Momozavur/STM32H743VIT6-FC/STM32H743VIT6 FC.kicad_pcb

## KiCad design STM32H743VIT6 FC.kicad_pcb (2025-11-29)

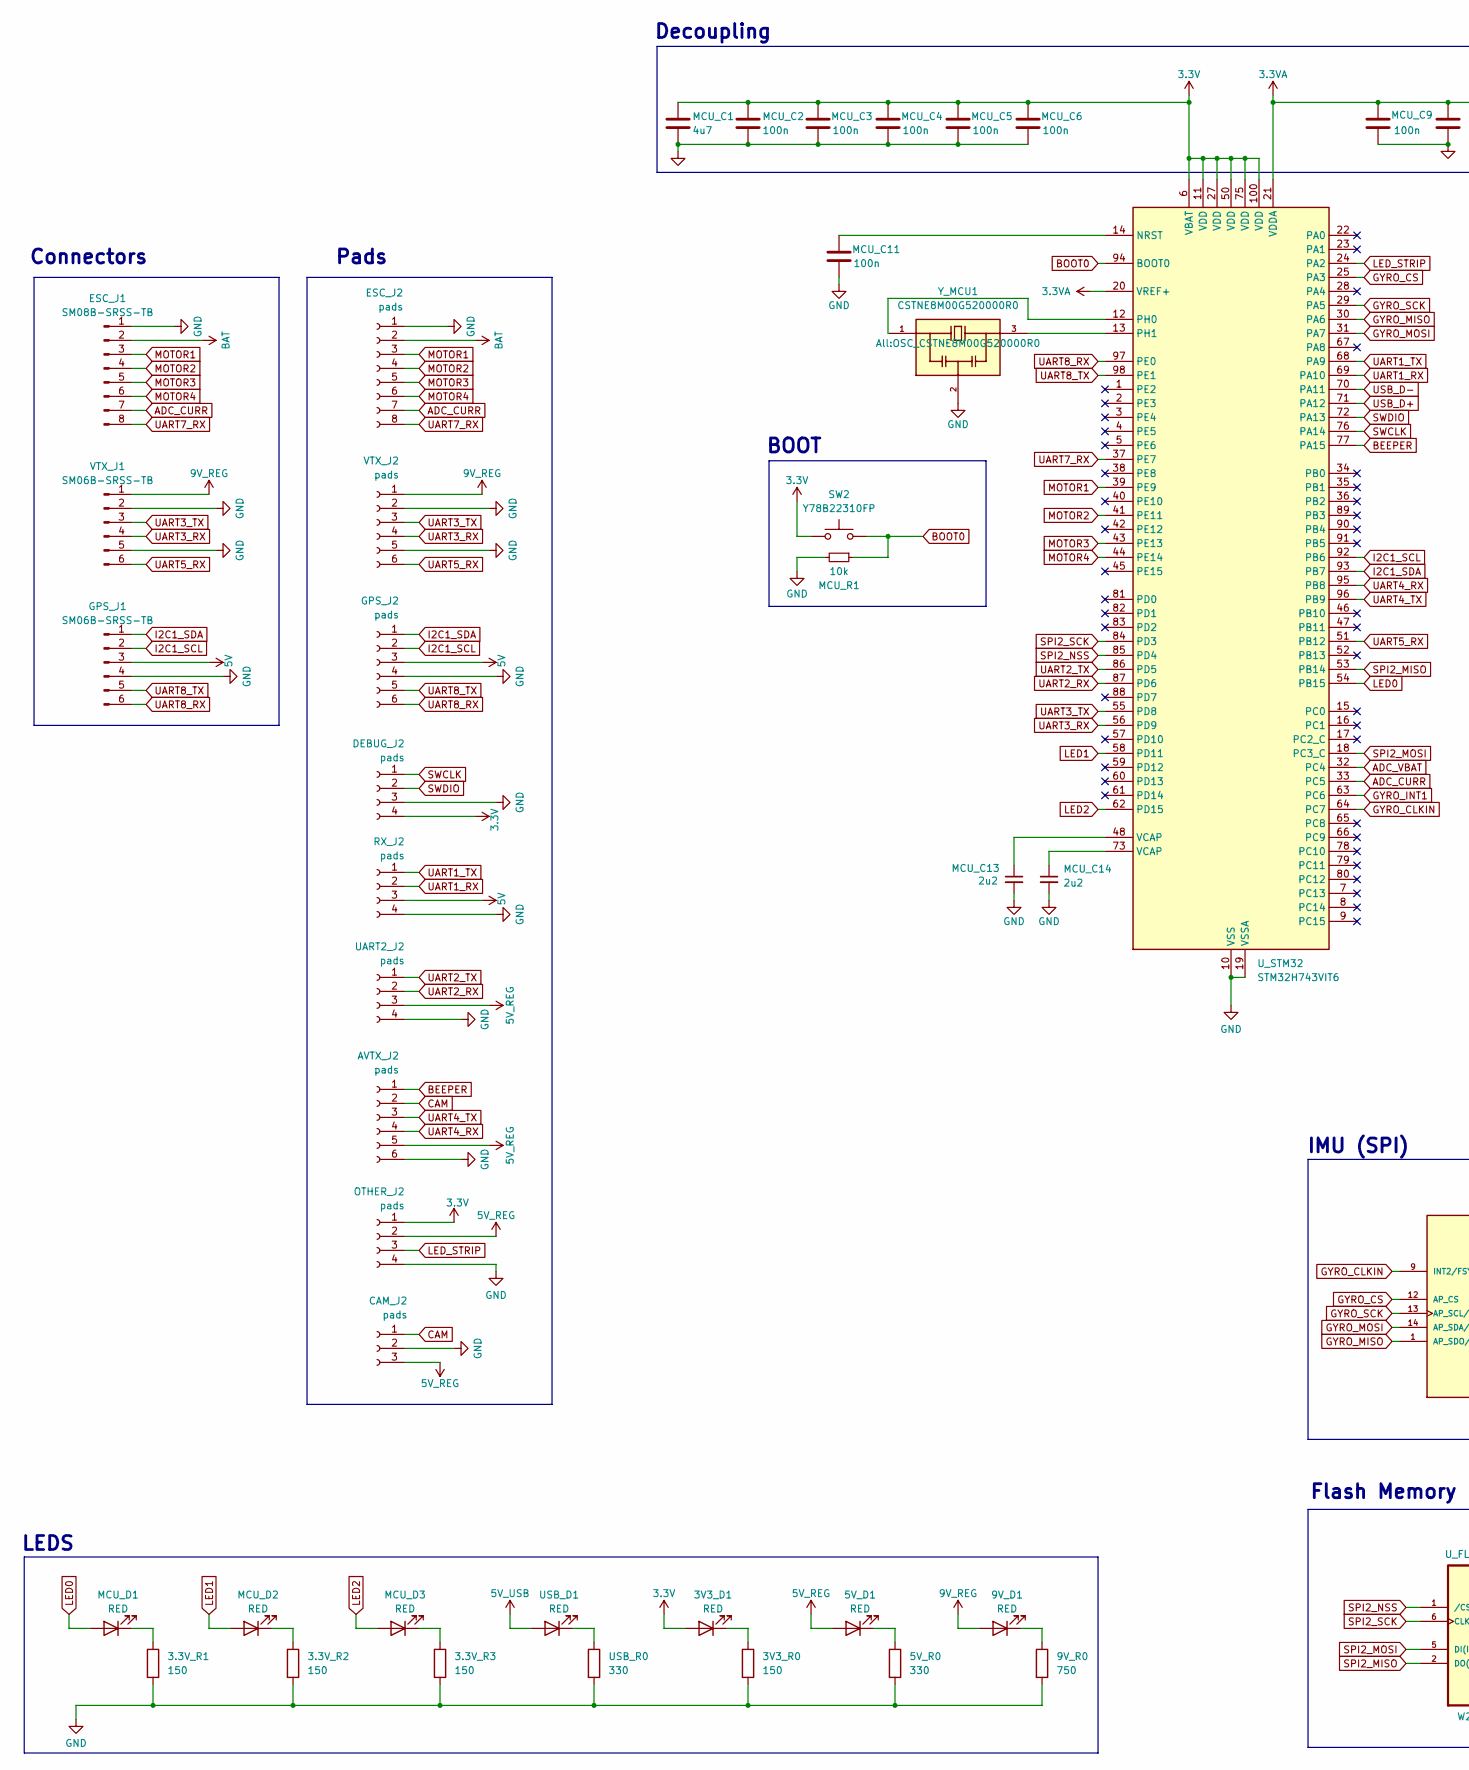
[picture p1: schematic STM32H743VIT6 FC.kicad_sch, part in row 1, column 1]

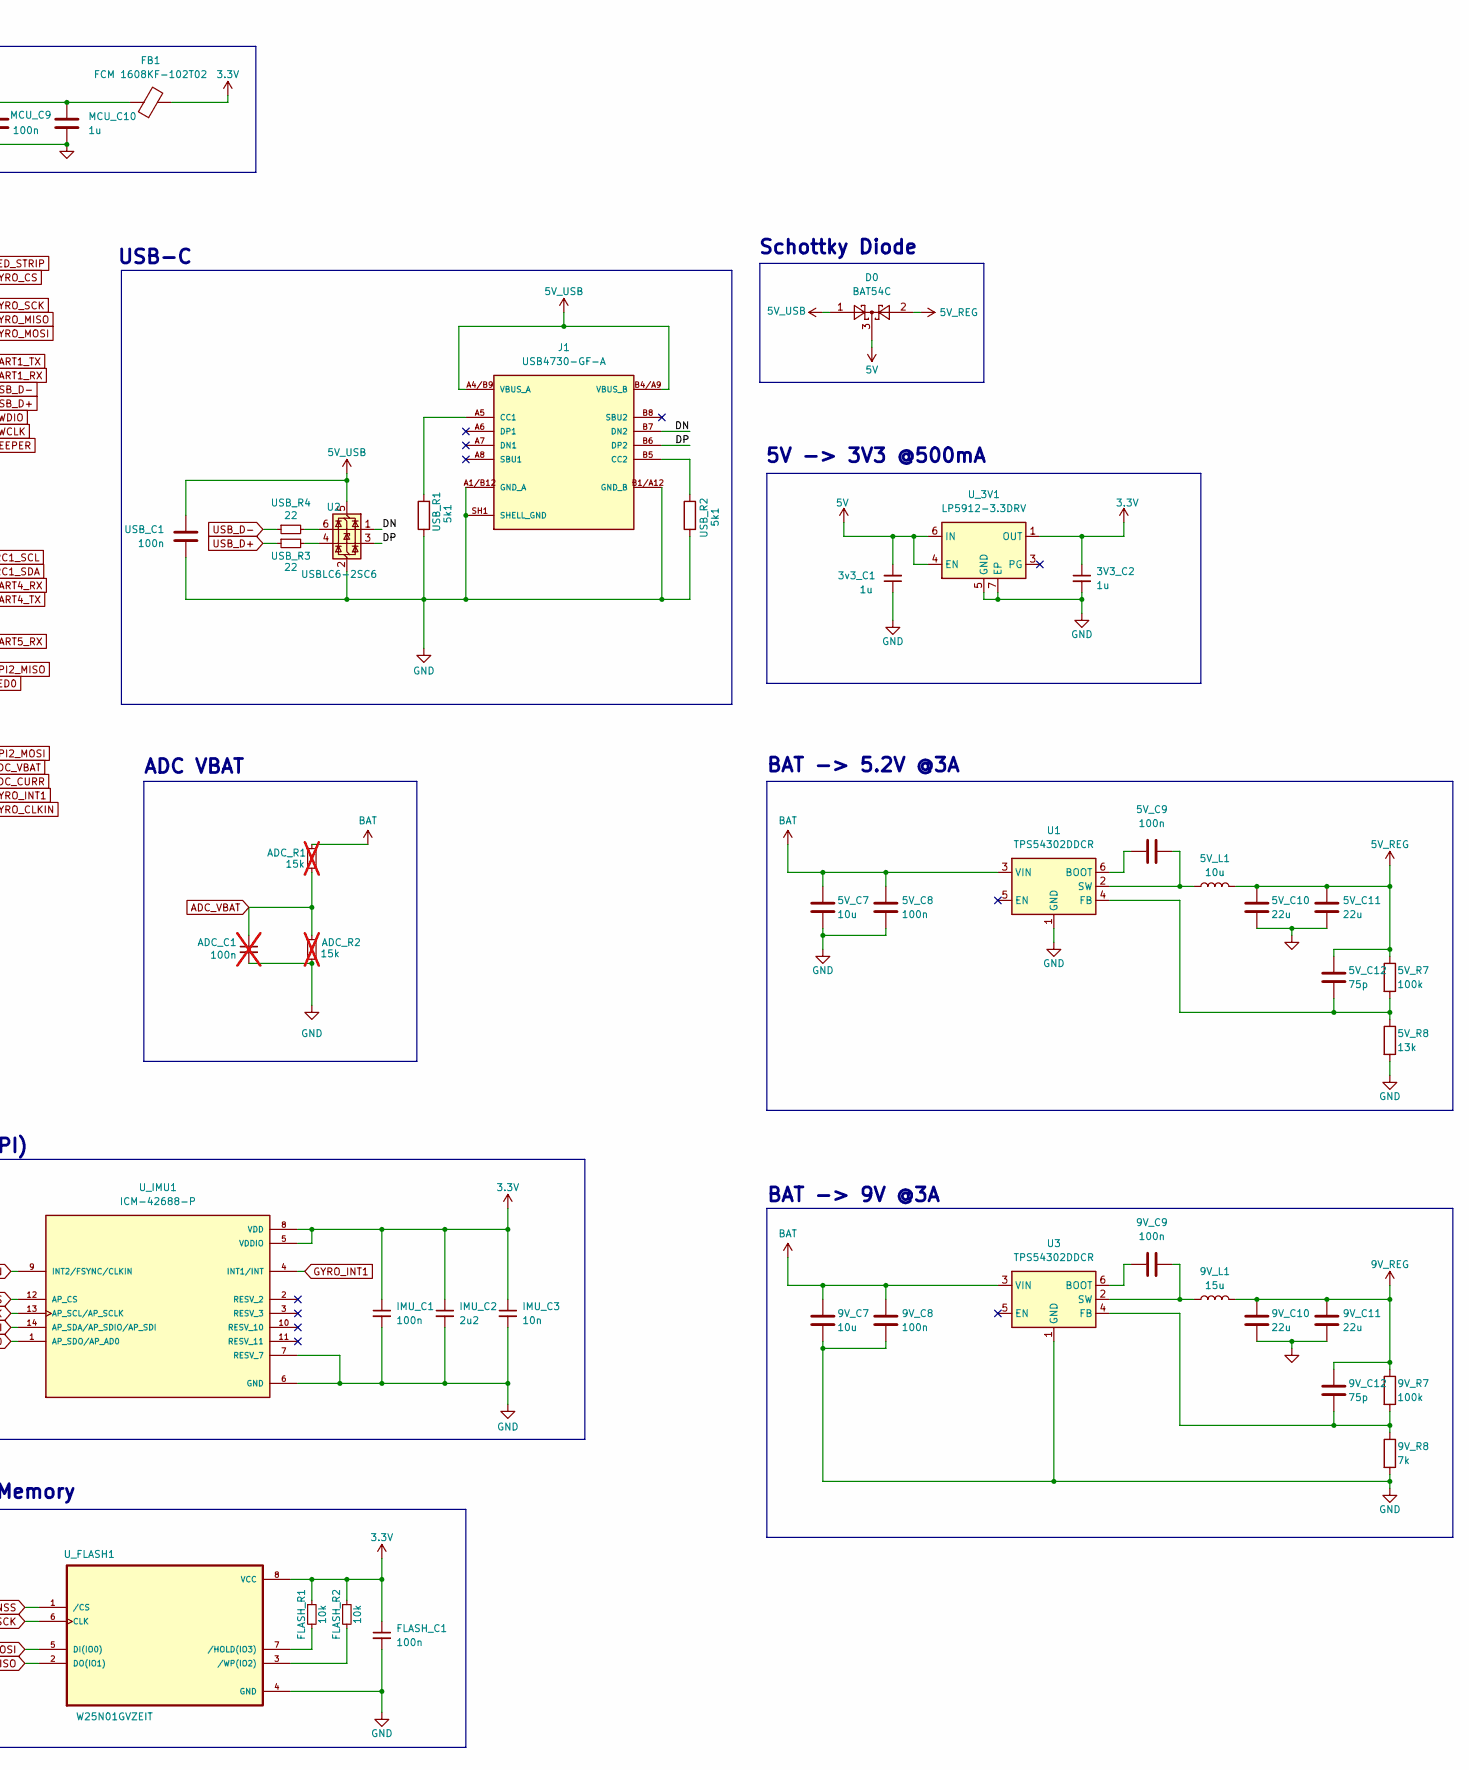
[picture p2: schematic STM32H743VIT6 FC.kicad_sch, part in row 1, column 2]

Parts:
3.3V_R1, 3.3V_R2, 3.3V_R3, 3V3_R0: 150; R_0603_1608Metric_Pad0.98x0.95mm_HandSolder
3V3_C2, 3v3_C1: 1u; C_0603_1608Metric_Pad1.08x0.95mm_HandSolder
3V3_D1, 5V_D1, 9V_D1: RED; LED_0603_1608Metric_Pad1.05x0.95mm_HandSolder
5V_C7, 9V_C7: 10u; C_0603_1608Metric_Pad1.08x0.95mm_HandSolder
5V_C8, 5V_C9, 9V_C8, 9V_C9: 100n; C_0603_1608Metric_Pad1.08x0.95mm_HandSolder
5V_C10, 5V_C11, 9V_C10, 9V_C11: 22u; C_0603_1608Metric_Pad1.08x0.95mm_HandSolder
5V_C12, 9V_C12: 75p; C_0603_1608Metric_Pad1.08x0.95mm_HandSolder
5V_L1: 10u; L_Wuerth_MAPI-5030
5V_R0: 330; R_0603_1608Metric_Pad0.98x0.95mm_HandSolder
5V_R7, 9V_R7: 100k; R_0603_1608Metric_Pad0.98x0.95mm_HandSolder
5V_R8: 13k; R_0603_1608Metric_Pad0.98x0.95mm_HandSolder
9V_L1: 15u; L_Wuerth_MAPI-5030
9V_R0: 750; R_0603_1608Metric_Pad0.98x0.95mm_HandSolder
9V_R8: 7k; R_0603_1608Metric_Pad0.98x0.95mm_HandSolder
ADC_C1: 100n; C_0603_1608Metric_Pad1.08x0.95mm_HandSolder; not fitted
ADC_R1, ADC_R2: 15k; R_0603_1608Metric_Pad0.98x0.95mm_HandSolder; not fitted
AVTX_J2: pads; Pads_1x6
CAM_J2: pads; Pads_1x3
D0: BAT54C; SOT-23
DEBUG_J2: pads; Pads_1x4
ESC_J1: SM08B-SRSS-TB; SM08BSRSSTB
ESC_J2: pads; Pads_1x8
FB1: FCM 1608KF-102T02; R_0603_1608Metric_Pad0.98x0.95mm_HandSolder
FLASH_C1: 100n; C_0603_1608Metric_Pad1.08x0.95mm_HandSolder
FLASH_R1, FLASH_R2: 10k; R_0603_1608Metric_Pad0.98x0.95mm_HandSolder
GPS_J1: SM06B-SRSS-TB; SM06BSRSSTBLFSN
GPS_J2: pads; Pads_1x6
IMU_C1: 100n; C_0603_1608Metric_Pad1.08x0.95mm_HandSolder
IMU_C2: 2u2; C_0603_1608Metric_Pad1.08x0.95mm_HandSolder
IMU_C3: 10n; C_0603_1608Metric_Pad1.08x0.95mm_HandSolder
J1: USB4730-GF-A; GCT_USB4730-GF-A_REVA; PARTREV A
MCU_C1: 4u7; C_0603_1608Metric_Pad1.08x0.95mm_HandSolder
MCU_C2, MCU_C3, MCU_C4, MCU_C5, MCU_C6, MCU_C9, MCU_C11: 100n; C_0603_1608Metric_Pad1.08x0.95mm_HandSolder
MCU_C10: 1u; C_0603_1608Metric_Pad1.08x0.95mm_HandSolder; JLCPCB Part # C19666
MCU_C13, MCU_C14: 2u2; C_0603_1608Metric_Pad1.08x0.95mm_HandSolder
MCU_D1, MCU_D2, MCU_D3: RED; LED_0603_1608Metric_Pad1.05x0.95mm_HandSolder
MCU_R1: 10k; R_0603_1608Metric_Pad0.98x0.95mm_HandSolder; JLCPCB Part # C25744
OTHER_J2: pads; Pads_1x4
RX_J2: pads; Pads_1x4
SW2: Y78B22310FP; SW_SPST_PTS810; JLCPCB Part # C127488
U1, U3: TPS54302DDCR; SOT-23-6
U2: USBLC6-2SC6; SOT-23-6
UART2_J2: pads; Pads_1x4
USB_C1: 100n; C_0603_1608Metric_Pad1.08x0.95mm_HandSolder
USB_D1: RED; LED_0603_1608Metric_Pad1.05x0.95mm_HandSolder
USB_R0: 330; R_0603_1608Metric_Pad0.98x0.95mm_HandSolder
USB_R1, USB_R2: 5k1; R_0603_1608Metric_Pad0.98x0.95mm_HandSolder
USB_R3, USB_R4: 22; R_0603_1608Metric_Pad0.98x0.95mm_HandSolder
U_3V1: LP5912-3.3DRV; WSON-6-1EP_2x2mm_P0.65mm_EP1x1.6mm_ThermalVias
U_FLASH1: W25N01GVZEIT; SON127P600X800X80-9N
U_IMU1: ICM-42688-P; PQFN50P300X250X97-14N; PARTREV 1.2
U_STM32: STM32H743VIT6; LQFP-100_14x14mm_P0.5mm
VTX_J1: SM06B-SRSS-TB; SM06BSRSSTBLFSN
VTX_J2: pads; Pads_1x6
Y_MCU1: CSTNE8M00G520000R0; OSC_CSTNE8M00G520000R0; PARTREV JGC42-8858A

Connections:
3.3V: 3V3_C2.1, 3V3_D1.2 (A), DEBUG_J2.4, FB1.2, FLASH_C1.1, FLASH_R1.1, FLASH_R2.1, IMU_C1.1, IMU_C2.1, IMU_C3.1, MCU_C1.1, MCU_C2.1, MCU_C3.1, MCU_C4.1, MCU_C5.1, MCU_C6.1, OTHER_J2.1, SW2.2, U_3V1.1 (OUT), U_FLASH1.8 (VCC), U_IMU1.5 (VDDIO), U_IMU1.8 (VDD), U_STM32.6 (VBAT), U_STM32.11 (VDD), U_STM32.27 (VDD), U_STM32.50 (VDD), U_STM32.75 (VDD), U_STM32.100 (VDD)
3.3VA: FB1.1, MCU_C9.1, MCU_C10.1, U_STM32.20 (VREF+), U_STM32.21 (VDDA)
5V: 3v3_C1.2, D0.3, GPS_J1.3, GPS_J2.3, RX_J2.3, U_3V1.4 (EN), U_3V1.6 (IN)
5V_REG: 5V_C10.1, 5V_C11.1, 5V_C12.1, 5V_D1.2 (A), 5V_L1.2, 5V_R7.1, AVTX_J2.5, CAM_J2.3, D0.2, OTHER_J2.2, UART2_J2.3
5V_USB: D0.1, J1.A4/B9 (VBUS_A), J1.B4/A9 (VBUS_B), U2.5 (VBUS), USB_C1.2, USB_D1.2 (A)
9V_REG: 9V_C10.1, 9V_C11.1, 9V_C12.1, 9V_D1.2 (A), 9V_L1.2, 9V_R7.1, VTX_J1.1, VTX_J2.1
/DN: J1.B7 (DN2), U2.1 (I/O1)
/DP: J1.B6 (DP2), U2.3 (I/O2)
ADC_CURR: ESC_J1.7, ESC_J2.7, U_STM32.33 (PC5)
ADC_VBAT: ADC_C1.1, ADC_R1.2, ADC_R2.1, U_STM32.32 (PC4)
BAT: 5V_C7.1, 5V_C8.1, 9V_C7.1, 9V_C8.1, ADC_R1.1, ESC_J1.2, ESC_J2.2, U1.3 (VIN), U3.3 (VIN)
BEEPER: AVTX_J2.1, U_STM32.77 (PA15)
BOOT0: MCU_R1.1, SW2.1, U_STM32.94 (BOOT0)
CAM: AVTX_J2.2, CAM_J2.1
GND: 3.3V_R1.2, 3.3V_R2.2, 3.3V_R3.2, 3V3_C2.2, 3V3_R0.2, 3v3_C1.1, 5V_C7.2, 5V_C8.2, 5V_C10.2, 5V_C11.2, 5V_R0.2, 5V_R8.2, 9V_C7.2, 9V_C8.2, 9V_C10.2, 9V_C11.2, 9V_R0.2, 9V_R8.2, ADC_C1.2, ADC_R2.2, AVTX_J2.6, CAM_J2.2, DEBUG_J2.3, ESC_J1.1, ESC_J2.1, FLASH_C1.2, GPS_J1.4, GPS_J2.4, IMU_C1.2, IMU_C2.2, IMU_C3.2, J1.A1/B12 (GND_A), J1.B1/A12 (GND_B), J1.SH1 (SHELL_GND), J1.SH2 (SHELL_GND), J1.SH3 (SHELL_GND), J1.SH4 (SHELL_GND), MCU_C1.2, MCU_C2.2, MCU_C3.2, MCU_C4.2, MCU_C5.2, MCU_C6.2, MCU_C9.2, MCU_C10.2, MCU_C11.2, MCU_C13.2, MCU_C14.2, MCU_R1.2, OTHER_J2.4, RX_J2.4, U1.1 (GND), U2.2 (GND), U3.1 (GND), UART2_J2.4, USB_C1.1, USB_R0.2, USB_R1.1, USB_R2.2, U_3V1.5 (GND), U_3V1.7 (EP), U_FLASH1.4 (GND), U_FLASH1.9, U_IMU1.6 (GND), U_IMU1.7 (RESV_7), U_STM32.10 (VSS), U_STM32.19 (VSSA), U_STM32.26 (VSS), U_STM32.49 (VSS), U_STM32.74 (VSS), U_STM32.99 (VSS), VTX_J1.2, VTX_J1.5, VTX_J2.2, VTX_J2.5, Y_MCU1.2
GYRO_CLKIN: U_IMU1.9 (INT2/FSYNC/CLKIN), U_STM32.64 (PC7)
GYRO_CS: U_IMU1.12 (AP_CS), U_STM32.25 (PA3)
GYRO_INT1: U_IMU1.4 (INT1/INT), U_STM32.63 (PC6)
GYRO_MISO: U_IMU1.1 (AP_SDO/AP_AD0), U_STM32.30 (PA6)
GYRO_MOSI: U_IMU1.14 (AP_SDA/AP_SDIO/AP_SDI), U_STM32.31 (PA7)
GYRO_SCK: U_IMU1.13 (AP_SCL/AP_SCLK), U_STM32.29 (PA5)
I2C1_SCL: GPS_J1.2, GPS_J2.2, U_STM32.92 (PB6)
I2C1_SDA: GPS_J1.1, GPS_J2.1, U_STM32.93 (PB7)
LED0: MCU_D1.2 (A), U_STM32.54 (PB15)
LED1: MCU_D2.2 (A), U_STM32.58 (PD11)
LED2: MCU_D3.2 (A), U_STM32.62 (PD15)
LED_STRIP: OTHER_J2.3, U_STM32.24 (PA2)
MOTOR1: ESC_J1.3, ESC_J2.3, U_STM32.39 (PE9)
MOTOR2: ESC_J1.4, ESC_J2.4, U_STM32.41 (PE11)
MOTOR3: ESC_J1.5, ESC_J2.5, U_STM32.43 (PE13)
MOTOR4: ESC_J1.6, ESC_J2.6, U_STM32.44 (PE14)
unnamed: 3V3_D1.1 (K), 3V3_R0.1
unnamed: 5V_D1.1 (K), 5V_R0.1
unnamed: 9V_D1.1 (K), 9V_R0.1
unnamed: J1.A5 (CC1), USB_R1.2
unnamed: J1.B5 (CC2), USB_R2.1
unnamed: MCU_C13.1, U_STM32.48 (VCAP)
unnamed: MCU_C14.1, U_STM32.73 (VCAP)
unnamed: 3.3V_R1.1, MCU_D1.1 (K)
unnamed: 3.3V_R2.1, MCU_D2.1 (K)
unnamed: 3.3V_R3.1, MCU_D3.1 (K)
unnamed: 5V_C9.1, U1.6 (BOOT)
unnamed: 5V_C12.2, 5V_R7.2, 5V_R8.1, U1.4 (FB)
unnamed: 5V_C9.2, 5V_L1.1, U1.2 (SW)
unnamed: U2.6 (I/O1), USB_R4.2
unnamed: U2.4 (I/O2), USB_R3.2
unnamed: 9V_C9.1, U3.6 (BOOT)
unnamed: 9V_C12.2, 9V_R7.2, 9V_R8.1, U3.4 (FB)
unnamed: 9V_C9.2, 9V_L1.1, U3.2 (SW)
unnamed: USB_D1.1 (K), USB_R0.1
unnamed: FLASH_R1.2, U_FLASH1.7 (/HOLD(IO3))
unnamed: FLASH_R2.2, U_FLASH1.3 (/WP(IO2))
unnamed: MCU_C11.1, U_STM32.14 (NRST)
unnamed: U_STM32.12 (PH0), Y_MCU1.1
unnamed: U_STM32.13 (PH1), Y_MCU1.3
SPI2_MISO: U_FLASH1.2 (DO(IO1)), U_STM32.53 (PB14)
SPI2_MOSI: U_FLASH1.5 (DI(IO0)), U_STM32.18 (PC3_C)
SPI2_NSS: U_FLASH1.1 (/CS), U_STM32.85 (PD4)
SPI2_SCK: U_FLASH1.6 (CLK), U_STM32.84 (PD3)
SWCLK: DEBUG_J2.1, U_STM32.76 (PA14)
SWDIO: DEBUG_J2.2, U_STM32.72 (PA13)
UART1_RX: RX_J2.2, U_STM32.69 (PA10)
UART1_TX: RX_J2.1, U_STM32.68 (PA9)
UART2_RX: UART2_J2.2, U_STM32.87 (PD6)
UART2_TX: UART2_J2.1, U_STM32.86 (PD5)
UART3_RX: U_STM32.56 (PD9), VTX_J1.4, VTX_J2.4
UART3_TX: U_STM32.55 (PD8), VTX_J1.3, VTX_J2.3
UART4_RX: AVTX_J2.4, U_STM32.95 (PB8)
UART4_TX: AVTX_J2.3, U_STM32.96 (PB9)
UART5_RX: U_STM32.51 (PB12), VTX_J1.6, VTX_J2.6
UART7_RX: ESC_J1.8, ESC_J2.8, U_STM32.37 (PE7)
UART8_RX: GPS_J1.6, GPS_J2.6, U_STM32.97 (PE0)
UART8_TX: GPS_J1.5, GPS_J2.5, U_STM32.98 (PE1)
USB_D+: USB_R3.1, U_STM32.71 (PA12)
USB_D-: USB_R4.1, U_STM32.70 (PA11)

Notes on the sheet:
Flash Memory
LEDS
Connectors
5V -> 3V3 @500mA
BAT -> 5.2V @3A
Schottky Diode
Decoupling
ADC VBAT
IMU (SPI)
Pads
BOOT
USB-C
BAT -> 9V @3A

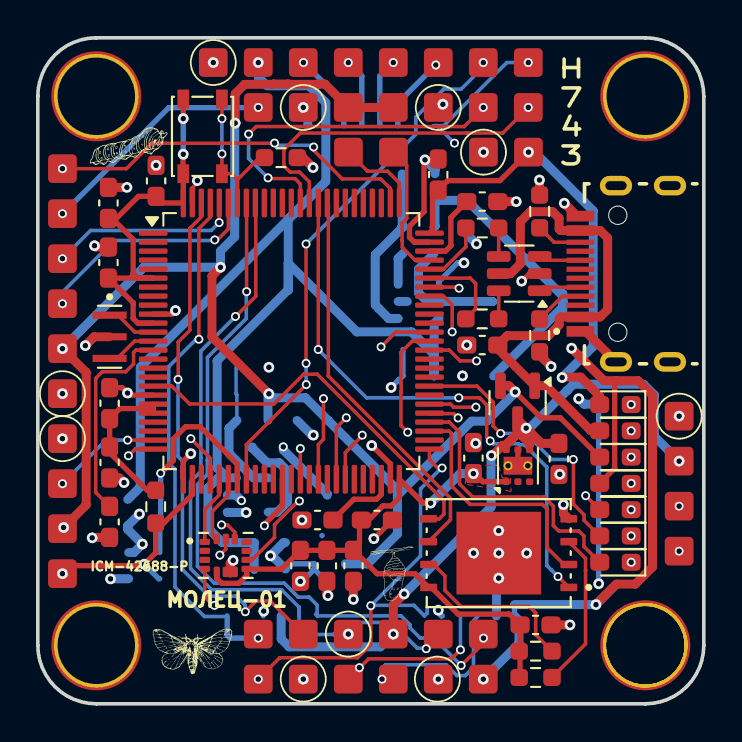
[picture p3: board STM32H743VIT6 FC.kicad_pcb from above]

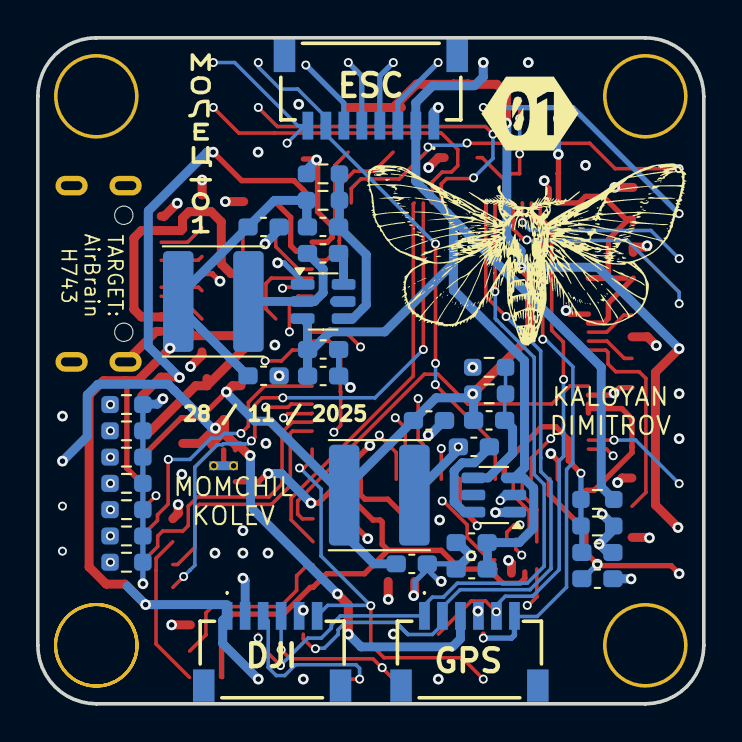
[picture p4: board STM32H743VIT6 FC.kicad_pcb from below]

Board: 4 copper layers, 37.0 x 37.0 mm, 89 parts (35 on the bottom side), 75 nets.

Other parts of the board:
H1, H2, H3, H4: MountingHole; MountingHole_4.3mm_M4_ISO14580_Pad_TopBottom
kibuzzard-692A4C78: G***; kibuzzard-692A4C78
