Momozavur/STM32H743VIT6-FC/(commit log)

2025-11-19 boom boom
    [power.kicad_sch]
2025-11-19 power mux
    [STM32H743VIT6 FC.kicad_sch, power.kicad_sch]
2025-11-19 single sheet
    [STM32H743VIT6 FC.kicad_sch, power.kicad_sch]
2025-11-19 mux no no no
    [STM32H743VIT6 FC.kicad_sch]
2025-11-21 Verified and connected IMU.
    [STM32H743VIT6 FC.kicad_sch]
2025-11-21 Verified baro, flash, and power. Added minimal pinout of the MCU.
    [STM32H743VIT6 FC.kicad_sch]
2025-11-21 3.3V ldo
    [STM32H743VIT6 FC.kicad_sch]
2025-11-23 Connected USB and fixed MCU decoupling.
    [STM32H743VIT6 FC.kicad_sch]
2025-11-23 Added all pins from config and removed unused.
    [STM32H743VIT6 FC.kicad_sch]
2025-11-24 led i buzzer
    [STM32H743VIT6 FC.kicad_sch]
2025-11-24 Added auxiliary pads.
    [STM32H743VIT6 FC.kicad_sch]
2025-11-24 Added footprints.
    [STM32H743VIT6 FC.kicad_pcb, STM32H743VIT6 FC.kicad_sch]
2025-11-24 Fixed imu and flash footprints.
    [STM32H743VIT6 FC.kicad_sch]
2025-11-24 Added 3D models.
    [STM32H743VIT6 FC.kicad_pcb]
2025-11-24 Fixed usb footprint.
    [STM32H743VIT6 FC.kicad_pcb, STM32H743VIT6 FC.kicad_sch]
2025-11-24 Board setup.
2025-11-24 Restored IMU 3D.
    [STM32H743VIT6 FC.kicad_pcb]
2025-11-24 Restored other footprints too.
    [STM32H743VIT6 FC.kicad_pcb]
2025-11-24 Changed inductor and added net classes.
    [STM32H743VIT6 FC.kicad_pcb, STM32H743VIT6 FC.kicad_sch]
2025-11-24 Added second inductor.
    [STM32H743VIT6 FC.kicad_pcb, STM32H743VIT6 FC.kicad_sch]
2025-11-25 Removed EN resistors from bucks.
    [STM32H743VIT6 FC.kicad_pcb, STM32H743VIT6 FC.kicad_sch]
2025-11-26 Placed voltage regs and wired motors, gyro, and flash.
    [STM32H743VIT6 FC.kicad_pcb]
2025-11-26 Moved 5V regulator.
    [STM32H743VIT6 FC.kicad_pcb]
2025-11-28 Moved voltage divider back and wired uarts.
    [STM32H743VIT6 FC.kicad_pcb, STM32H743VIT6 FC.kicad_sch]
2025-11-28 blizo sme batkuu
    [STM32H743VIT6 FC.kicad_pcb]
